WNijhof/RPi-Jukebox-RFID/behuizing/stl/deksel.stl

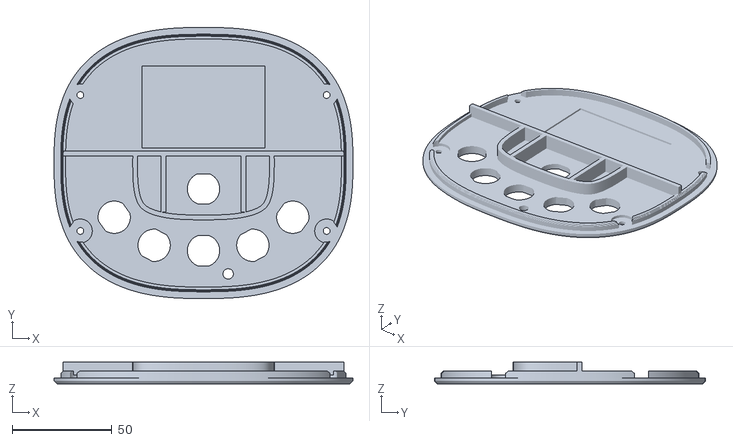
[picture p28: CAD file, 2026-10-31]
behuizing/stl/deksel.stl
150.0 x 136.0 x 11.0
