WNijhof/RPi-Jukebox-RFID/behuizing/stl/oud/deksel-3mm-2026-10-30.stl

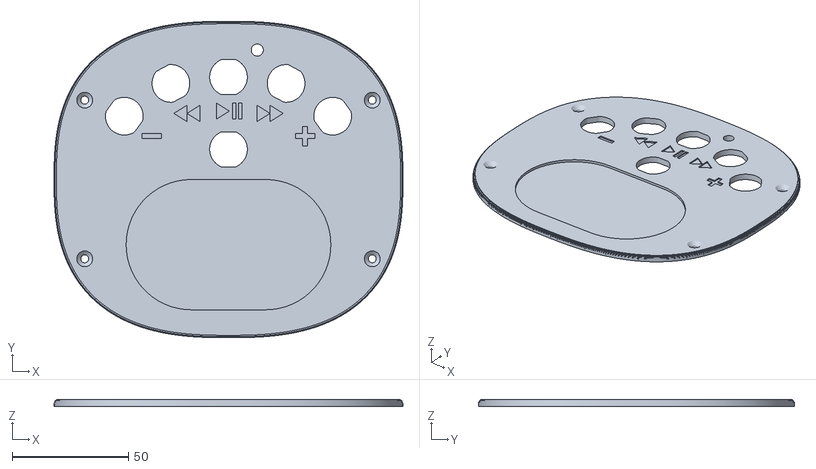
[picture p29: CAD file, 2026-10-31]
behuizing/stl/oud/deksel-3mm-2026-10-30.stl
150.0 x 136.0 x 3.00
