WNijhof/RPi-Jukebox-RFID/behuizing/stl/onderbak.stl

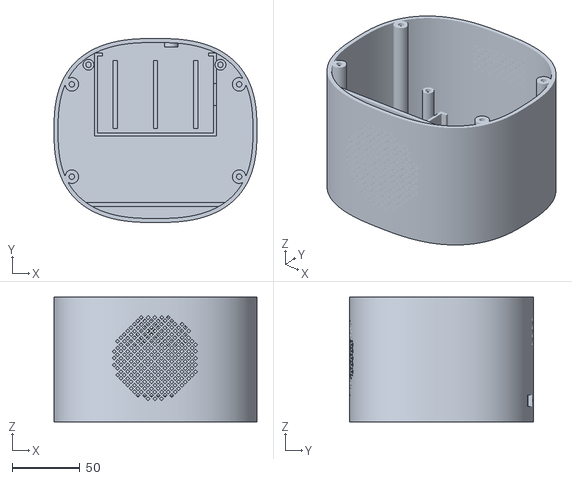
[picture p30: CAD file, 2026-10-31]
behuizing/stl/onderbak.stl
150.0 x 136.0 x 92.0
