WNijhof/RPi-Jukebox-RFID/behuizing/stl/kooibeugel.stl

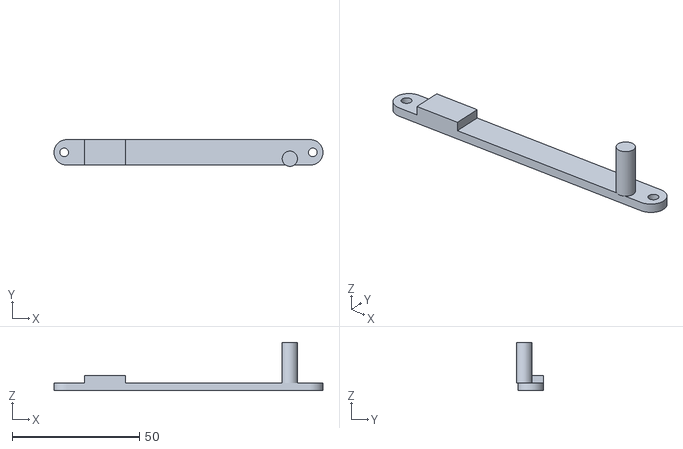
[picture p31: CAD file, 2026-10-31]
behuizing/stl/kooibeugel.stl
105.5 x 10.5 x 19.0
