WNijhof/RPi-Jukebox-RFID/behuizing/stl/drukstift.stl

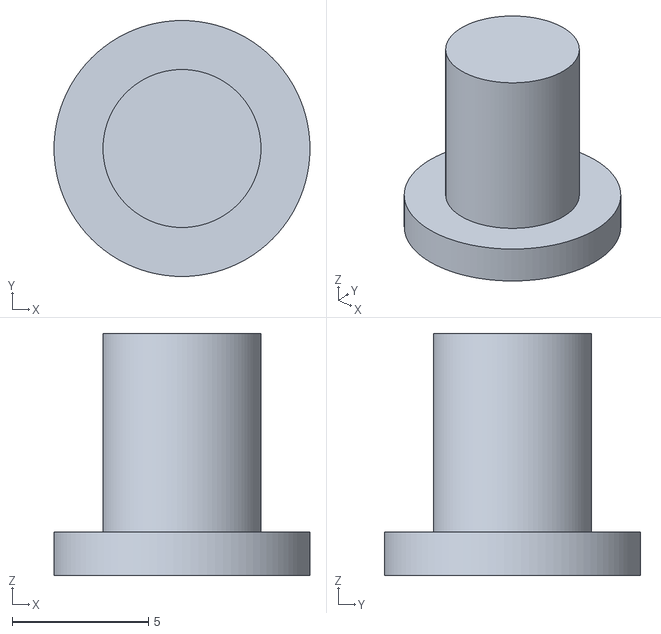
[picture p32: CAD file, 2026-10-31]
behuizing/stl/drukstift.stl
9.40 x 9.40 x 8.89
