WNijhof/RPi-Jukebox-RFID/resources/default-settings/jukebox.default.yaml

# IMPORTANT:
# Always use relative path from folder `src/jukebox` (`../../`), but do not use relative paths with `~/`.
# Sole (!) exception is in playermpd.mpd_conf
system:
  box_name: Jukebox
modules:
  named:
    # Do not change the order!
    publishing: publishing
    volume: volume
    jingle: jingle
    jingle.alsawave: jingle.alsawave
    jingle.jinglemp3: jingle.jinglemp3
    player: playermpd
    spotify: spotify
    cards: rfid.cards
    rfid: rfid.reader
    timers: timers
    host: hostif.linux
    bluetooth_audio_buttons: controls.bluetooth_audio_buttons
    gpio: gpio.gpioz.plugin
    sync_rfidcards: synchronisation.rfidcards
    # Eigen uitbreiding muziekbox: battery level of the PiSugar 3 Plus
    battmon: battery_monitor.batt_mon_pisugar
  others:
  - misc
pulse:
  # Reset system volume to this level after start. (Comment out disables and volume is not changed)
  startup_volume: 40
  # Automatically toggle output between primary and secondary audio output
  # when a device connects (Note: So far, toggle happens when ANY device connects)
  toggle_on_connect: true
  # Limit maximum volume range to XX % - can be changed through the UI (for temporary use)
  soft_max_volume: 70
  # Run the audio configuration tool to configure the pulseaudio sinks
  #
  # After startup, the audio output defaults to primary
  # Any Bluetooth device should be the secondary (as it may not always be available directly after boot)
  #
  # For manual setting of pulseaudio sinks use:
  # $ pactl list sinks short
  #
  # Test sinks with
  # $ paplay -D sink_name /usr/share/sounds/alsa/Front_Center.wav
  #
  # Parameters:
  # - alias       : user defined alias for better readability
  # - volume_limit: a hard volume limit representing the new 100 %
  #                 i.e. the user input range 0...100 % will be scaled into this range
  #                 this can be used to attenuate the maximum volume levels between different outputs
  #                 i.e. make both channels equally load out 100 % and make sure it never gets too loud
  outputs:
    primary:
      alias: Built-in speakers
      volume_limit: 100
      soft_max_volume: 100
      # Leave pulse_sink_name empty for first start-up (will be filled with systems default sink)
      # pulse_sink_name: alsa_output.pci-0000_00_1f.3.analog-stereo
    secondary:
      alias: Bluetooth headset
      volume_limit: 100
      soft_max_volume: 100
      # Leave pulse_sink_name unfilled to disable secondary output
      # pulse_sink_name: bluez_sink.C4_FB_20_63_CO_FE.a2dp_sink
jingle:
   # Supported file formats as jingles: *.wav and *.mp3. Note that *.wav is faster!
  startup_sound: ../../resources/audio/startupsound.wav
  # startup_sound: ../../resources/audio/startupsound.mp3
  # Shutdown sound is not played on Ctrl-C (to reduce developer's stain)
  shutdown_sound: ../../resources/audio/shutdownsound.wav
  # Use file ending to choose player from available jingle services
  service: auto
  # The playback volume of the jingles. (Comment out means use current system volume)
  volume: 30
jinglemp3:
  # Config of the MP3 Jingle Service
  # These parameters are passed to the mpeg123 player (e.g. [-d 2])
  call_parameters: []
alsawave:
  # Config of the Wave through ALSA Jingle Service
  device: default
playermpd:
  host: localhost
  status_file: ../../shared/settings/music_player_status.json
  second_swipe_action:
    # Note: Does not follow the RPC alias convention (yet)
    # Must be one of: 'toggle', 'play', 'skip', 'rewind', 'replay', 'none'
    alias: toggle
  library:
    update_on_startup: true
    check_user_rights: true
  mpd_conf: ~/.config/mpd/mpd.conf
  # Must be one of: 'none', 'stop', 'rewind':
  end_of_playlist_next_action: none
  # Must be one of: 'none', 'prev', 'rewind':
  stopped_prev_action: prev
  # Must be one of: 'none', 'next', 'rewind':
  stopped_next_action: next
rpc:
  tcp_port: 5555
  websocket_port: 5556
publishing:
  # Ports for the publisher. Setting a port number to 0 disables the port
  # The WebUI requires the websocket connection
  tcp_port: 5558
  websocket_port: 5557
rfid:
  reader_config: ../../shared/settings/rfid.yaml
  card_database: ../../shared/settings/cards.yaml
battmon:
  # Eigen uitbreiding muziekbox: PiSugar 3 Plus via pisugar-server
  pisugar_host: 127.0.0.1
  pisugar_port: 8423
  interval_sec: 10
  # Below this level (on battery): run warning_action once, e.g. {alias: set_volume, args: 20}
  warning_level: 10
  warning_action:
  all_clear_action:
  # Below this level (on battery): shut down cleanly
  shutdown_level: 3
  # From this level (on the charger): the status LED stops blinking and stays on
  full_level: 98
  # Below this level (on battery): play low_sound once, just before the box switches off
  sound_level: 7
  low_sound: ../../resources/audio/lowbatterysound.wav
  # History of how long the box runs per charge, shown in the Web App
  cycles_file: ../../shared/settings/battery_cycles.json
spotify:
  # Eigen uitbreiding muziekbox
  # Name of the Spotify Connect speaker (must match --device-name of Soloist, see setup_spotify.sh)
  device_name: Muziekbox
  token_file: ../../shared/settings/spotify_token.json
  resume_file: ../../shared/settings/spotify_resume.json
  # Default for cards: shuffle on/off
  shuffle: false
  # Continue a playlist/album/audiobook where it was left
  resume: true
  # Same card again while its content is loaded: play (continue if paused) | toggle | restart | none
  second_swipe_action: play
  poll_interval_active_sec: 2
  poll_interval_idle_sec: 15
gpioz:
  enable: false
  config_file: ../../shared/settings/gpio.yaml
  # Eigen uitbreiding muziekbox: names of the buttons switched off in the Web App
  disabled_inputs: []
timers:
  idle_shutdown:
    # If you want the box to shutdown on inactivity automatically, configure timeout_sec with a number of seconds (at least 60).
    # Inactivity is defined as: no music playing, no active SSH sessions, no changes in configs or audio content.
    timeout_sec: 0
  # These timers are always disabled after start
  # The following values only give the default values.
  # These can be changed when enabling the respective timer on a case-by-case basis w/o saving
  shutdown:
    default_timeout_sec: 3600
  stop_player:
    default_timeout_sec: 3600
  volume_fade_out:
    default_time_per_iteration_sec: 900
    number_of_steps: 10
host:
  # Do not actually execute system shutdown and reboot commands
  debug_mode: false
  # Whether to publish the host's temperature regularly
  publish_temperature:
    enabled: true
    timer_interval_sec: 10
  # Should we disable the power management of the WLAN to ensure reachability via WLAN?
  wlan_power:
    disable_power_down: false
    # Specify the wlan interface. Get a list from $iwconfig. 'wlan0' is default on RPis
    card: wlan0
  # RPi-specific stuff. Will be silently ignored if not on an RPi
  rpi:
    hdmi_power_down: false
bluetooth_audio_buttons:
  # When a bluetooth sound device (headphone, speakers) connects
  # attempt to automatically listen to it's buttons (play, next, ...)
  # Note that volume up/down is handled independently from this by the bluetooth audio protocol
  enable: true
# Espeak is the current speech synthesizer
speaking_text:
  # All languages available here: http://espeak.sourceforge.net/languages.html
  lang: en
  # Must be one of: normal, fast, slow
  speed: normal
  # Whether you want to read punctuation or not
  speak_punct: False
  # Must be one of: female, male, croak, whisper
  voice: female
sync_rfidcards:
  enable: false
  config_file: ../../shared/settings/sync_rfidcards.yaml
webapp:
  coverart_cache_path: ../../src/webapp/build/cover-cache
  # Load cover arts in Webapp. Change to false in case you have performance issue
  # when handling a lot of music
  # Defaults to true
  show_covers: true
