WNijhof/RPi-Jukebox-RFID/(commit log)

2026-10-27 Eigen uitbreiding muziekbox: Spotify, PiSugar-accu en bouwhandleiding
    - Spotify-module: kaarten starten playlists/albums via Spotify Connect (librespot)
    en de Web API; knoppen, webapp en timers worden naar Spotify doorgestuurd
    - Webapp: actie "Spotify" bij het koppelen van kaarten
    - Batterijmonitor voor de PiSugar 3 Plus (pisugar-server)
    - Setup-script voor librespot en de Spotify-koppeling
    - Bouwhandleiding, Spotify- en accuhandleiding en GPIO-configuratie in eigen/
2026-10-27 Bouwdocumentatie uit de repository gehaald
    De handleidingen worden lokaal bijgehouden; verwijzingen in code en config aangepast.
2026-10-27 Webpagina vooraf bouwen via GitHub Actions
    Bij elke push naar eigen/main bouwt de workflow eigen_webapp_build.yml de
    webpagina en zet hem als webapp-build-<commit>.tar.gz bij de release
    eigen-webapp. Het installatiescript pakt bij onze branch die build en vraagt
    niet meer of het zelf moet bouwen. Is er voor de commit (nog) geen build,
    dan bouwt de Pi hem zelf zoals voorheen.
2026-10-27 gpio.yaml: lang drukken op Vorige werkte niet
    De alias 'replay' bestaat niet, waardoor de knop bij lang drukken niets deed.
    De opdracht staat nu voluit (player.ctrl.replay); tijdens Spotify wordt die
    doorgestuurd naar de Spotify-code.
2026-10-27 Spotify-luidspreker: librespot vervangen door Spotify Soloist
    Spotify geeft bij een deel van de accounts geen audiosleutels meer aan
    librespot ("audio key error"), waardoor elk nummer wordt overgeslagen
    (librespot-org/librespot#1649). Soloist is de officiele headless Spotify
    Connect-client van Spotify.
    - setup_spotify.sh installeert Soloist in ~/.local/lib/soloist. Soloist heeft
    glibc 2.38 nodig; op Bookworm (2.36) haalt het script de glibc van Debian
    Trixie op en laat alleen Soloist daarnaar verwijzen (patchelf).
    - De API-sleutel staat in ~/.config/soloist/soloist.env (alleen leesbaar voor
    de gebruiker), niet in de unit.
    - Builds verlopen na 90 dagen: soloist-update.timer haalt dagel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
    [jukebox.default.yaml]
2026-10-27 Spotify-koppeling en automatisch uitschakelen repareren
    - webapi.py: de Jukebox las het Spotify-tokenbestand alleen bij het starten.
    Na opnieuw koppelen, of als een ander proces het token ververste (Spotify
    roteert dan de refresh token), bleef de dienst een ongeldig token gebruiken
    en zag hij niet dat Spotify speelde. Het bestand wordt nu opnieuw ingelezen
    als het op schijf veranderd is, en atomair weggeschreven.
    - idle_shutdown_timer.py: GenericMultiTimerClass geeft iterations/iteration
    mee, IdleShutdown accepteerde die niet. Daardoor ging de box nooit vanzelf
    uit (TypeError in het log). Bug uit future3/main, upstream inmiddels
    herschreven (#2689).
    - Tests voor beide.
    Co-Auth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
2026-10-27 Spotify: tweede kaartscan na stoppen en pauze zonder fout
    - Een tweede scan van dezelfde kaart hervat het afspelen. Was Spotify in de
    tussentijd helemaal gestopt, dan weigerde Spotify dat (403 Restriction
    violated) en gebeurde er niets. De kaart start nu opnieuw.
    - Pauze terwijl Spotify al gepauzeerd of gestopt is, gaf dezelfde 403 als
    fout. Dat wordt nu genegeerd.
    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
2026-10-30 Automatische updates via GitHub-release en knoppen uitzetten in de Web App
    - update_jukebox.sh + jukebox-update.timer: installeert de nieuwste release
    zodra er geen muziek speelt, met terugval naar de oude versie
    - Settings -> Buttons: elke knop los uit te zetten, direct opgeslagen in
    gpioz.disabled_inputs
2026-10-30 Accu: LED knippert tijdens laden, box blijft aan aan de lader
    - Status-LED knippert tijdens laden en brandt continu zodra de accu vol is
    - Idle-shutdown wacht zolang de lader erin zit
    - Update-resultaat in shared/logs/update.log, de journal op de Pi is vluchtig
2026-10-30 Web App: geinstalleerde Muziekbox-release tonen
    Nieuwe regel bij Settings -> System, zodat je ziet of een update is
    aangekomen. misc.get_release geeft git describe terug.
2026-10-30 Accu: waarschuwing als hij bijna leeg is en gebruik per lading
    - Snel knipperende LED onder warning_level, geluid bij sound_level
    - Per lading bijhouden hoe lang de box aanstond en hoeveel muziek speelde,
    zichtbaar in de Web App bij Settings
2026-10-30 Equalizer in de Web App en kaartnaam in het overzicht
    Settings > Audio krijgt een 10-bands equalizer met schuiven en presets.
    De waarden staan in de ladspa-module en in default.pa, zodat ze een
    herstart overleven. Bij een wijziging wacht de code tot de oude module weg
    is: anders krijgt de nieuwe sink een naam met een achtervoegsel.
    Een Spotify-kaart toont in het overzicht zijn naam als hoofdregel.
2026-10-31 Behuizing en handleiding toegevoegd; deksel stijver en tweekleurig
    De map behuizing bevat het parametrische model en de STL's, de map
    documentatie de bouwhandleiding met PDF. Het deksel is herzien: ruggen,
    verdikte strook bij de knoppen, rand met inloop die in de bak valt,
    NFC-vlak van 2 mm en ondersteboven printen met een filamentwissel.
    [deksel-3mm-2026-10-30.stl, deksel.stl, drukstift.stl, kooibeugel.stl, onderbak.stl]
